GadgetReboot/Rotary_Optical_USB/README.md

# Rotary_Optical_USB
Pi Pico USB Mouse/Keyboard for Arcade Trackball/Spinner and LS30 Mechanical Rotary Joysticks
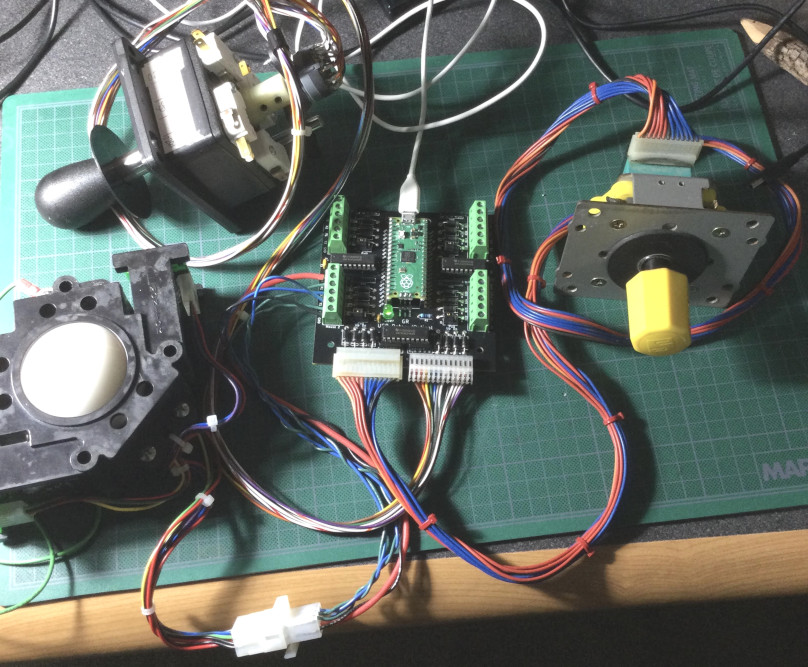
[picture p1: Assembled_PCB.jpg]
PCB
<br><br><br><br>
