GadgetReboot/Rotary_Optical_USB/Alternate_Script_All_Button_Inputs/readme.md

This is a test script that can be used in the pi pico to set all screw terminal inputs as regular button inputs instead of optical encoders to allow fast testing of inputs by grounding each one to generate a keystroke.
