GadgetReboot/Rotary_Optical_USB/RotaryOptical-Schematic.pdf

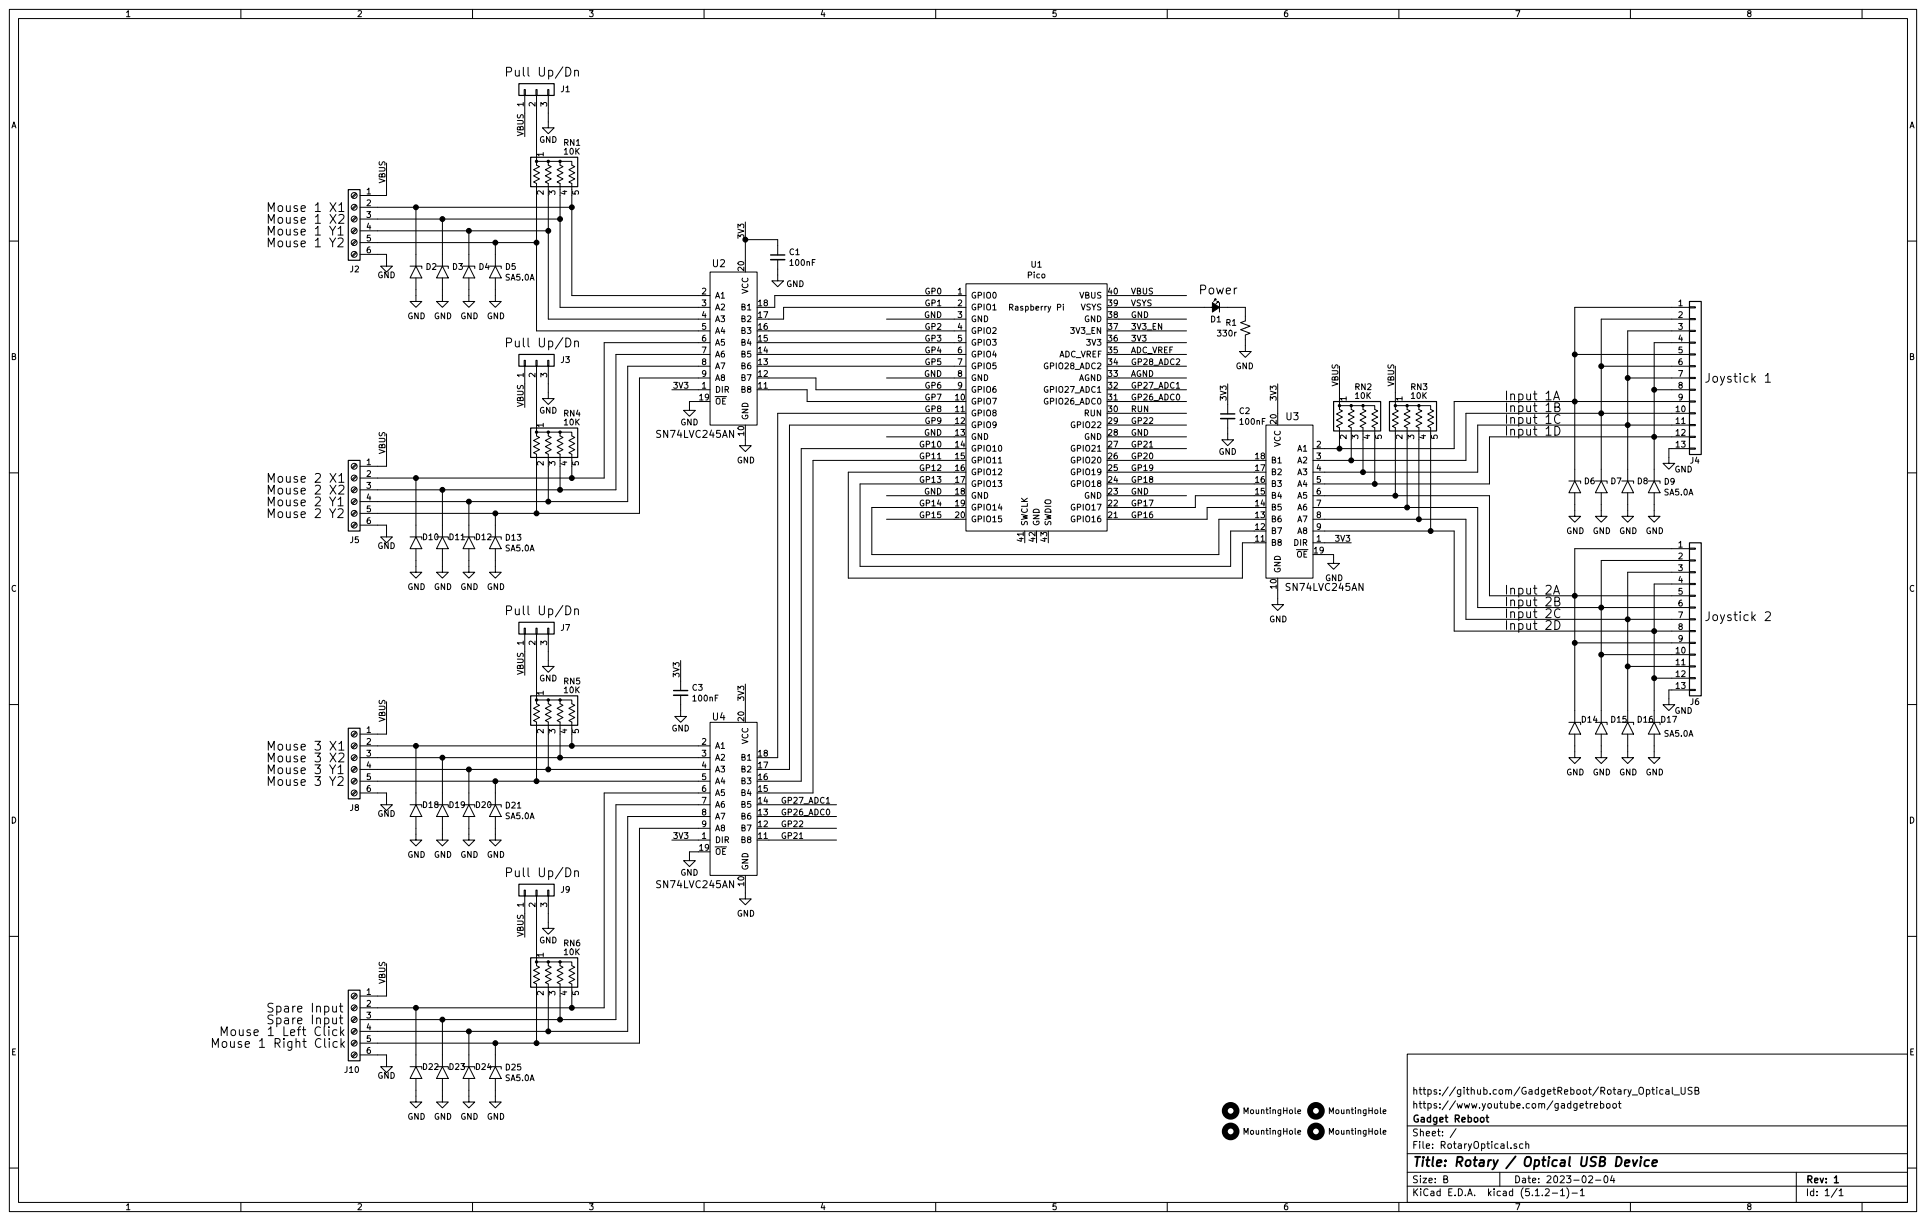
[picture p3: page 1]

Input 1B | 10
Input 1C | 11
Input 1D | 12

Input 2B | 1323456789

Input 2C
Input 2D

10
11
12

https://github.com/GadgetReboot/Rotary_Optical_USB
https://www.youtube.com/gadgetreboot
File: RotaryOptical.sch Sheet: / Gadget Reboot

Id: 1/1 Title: Rotary / Optical USB Device
