GadgetReboot/Rotary_Optical_USB/KiCad/RotaryOptical.kicad_pcb

## KiCad design KiCad/RotaryOptical.kicad_pcb (2023-03-07)

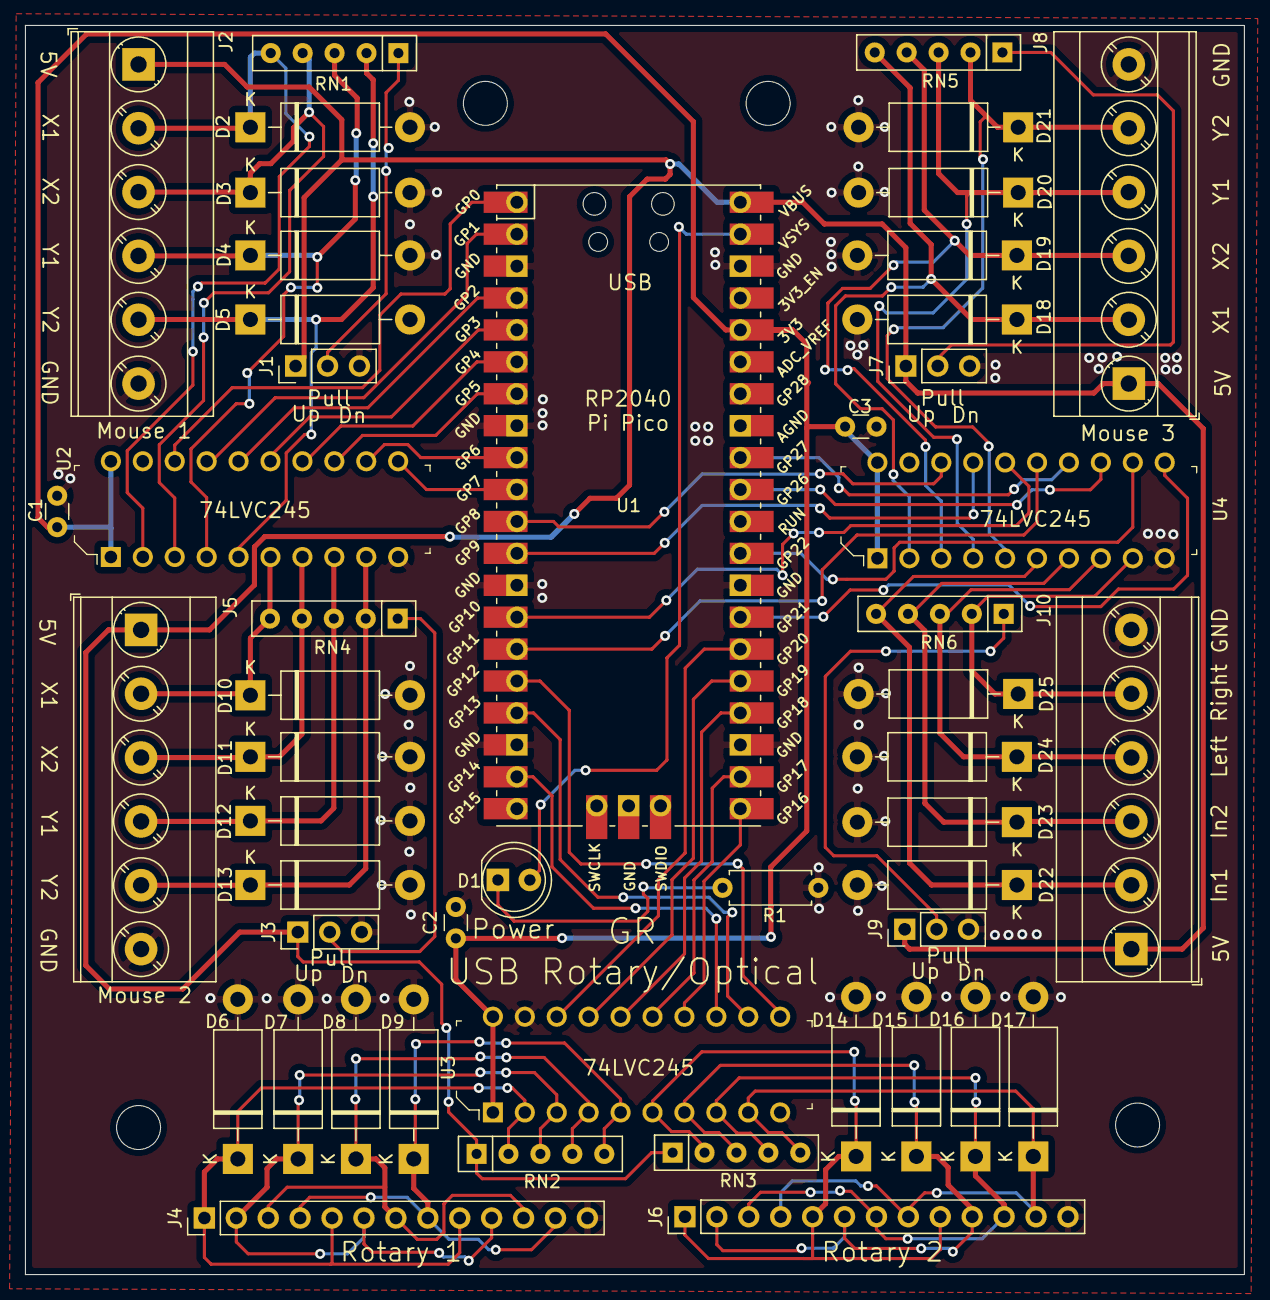
[picture p4: board RotaryOptical.kicad_pcb from above]

Board: 2 copper layers, 97.0 x 99.4 mm, 53 parts (0 on the bottom side), 57 nets.

Parts:
C1, C2, C3: 100nF; C_Disc_D3.0mm_W1.6mm_P2.50mm
D1: LED_Small_ALT; LED_D5.0mm_Clear
D2, D3, D4, D5, D6, D7, D8, D9, D10, D11, D12, D13, D14, D15, D16, D17, D18, D19, D20, D21, D22, D23, D24, D25: SA5.0A; D_DO-15_P12.70mm_Horizontal
H1, H2, H3, H4: MountingHole; MountingHole_3.5mm
J1, J3, J7, J9: Conn_01x03; PinHeader_1x03_P2.54mm_Vertical
J2, J5, J8, J10: Screw_Terminal_01x06; TerminalBlock_Phoenix_MKDS-3-6-5.08_1x06_P5.08mm_Horizontal
J4, J6: Conn_01x13; PinHeader_1x13_P2.54mm_Vertical
R1: 470r; R_Axial_DIN0207_L6.3mm_D2.5mm_P7.62mm_Horizontal
RN1, RN2, RN3, RN4, RN5, RN6: 10K; R_Array_SIP5
U1: Pico; RPi_Pico_SMD_TH
U2, U3, U4: SN74LVC245AN; DIP-20_W7.62mm

Connections:
/3V3: C1.1, C2.1, C3.1, U1.36, U2.1, U2.20, U3.1, U3.20, U4.1, U4.20
/GP0: U1.1, U2.18
/GP1: U1.2, U2.17
/GP2: U1.4, U2.16
/GP3: U1.5, U2.15
/GP4: U1.6, U2.14
/GP5: U1.7, U2.13
/GP6: U1.9, U2.12
/GP7: U1.10, U2.11
/GP8: U1.11, U4.18
/GP9: U1.12, U4.17
/GP10: U1.14, U4.16
/GP11: U1.15, U4.15
/GP12: U1.16, U3.11
/GP13: U1.17, U3.12
/GP14: U1.19, U3.13
/GP16: U1.21, U3.14
/GP17: U1.22, U3.15
/GP18: U1.24, U3.16
/GP19: U1.25, U3.17
/GP20: U1.26, U3.18
/GP21: U1.27, U4.11
/GP22: U1.29, U4.12
/GP26_ADC0: U1.31, U4.13
/GP27_ADC1: U1.32, U4.14
/VBUS: J1.1, J2.1, J3.1, J5.1, J7.1, J8.1, J9.1, J10.1, RN2.1, RN3.1, U1.40
/VSYS: D1.2, U1.39
GND: C1.2, C2.2, C3.2, D2.2, D3.2, D4.2, D5.2, D6.2, D7.2, D8.2, D9.2, D10.2, D11.2, D12.2, D13.2, D14.2, D15.2, D16.2, D17.2, D18.2, D19.2, D20.2, D21.2, D22.2, D23.2, D24.2, D25.2, J1.3, J2.6, J3.3, J4.13, J5.6, J6.13, J7.3, J8.6, J9.3, J10.6, R1.2, U1.3, U1.8, U1.13, U1.18, U1.23, U1.28, U1.38, U2.10, U2.19, U3.10, U3.19, U4.10, U4.19
unnamed: D1.1, R1.1
unnamed: D2.1, J2.2, RN1.5, U2.2
unnamed: D3.1, J2.3, RN1.4, U2.3
unnamed: D4.1, J2.4, RN1.3, U2.4
unnamed: D5.1, J2.5, RN1.2, U2.5
unnamed: D6.1, J4.1, J4.5, J4.9, RN2.2, U3.2
unnamed: D7.1, J4.2, J4.6, J4.10, RN2.3, U3.3
unnamed: D8.1, J4.3, J4.7, J4.11, RN2.4, U3.4
unnamed: D9.1, J4.4, J4.8, J4.12, RN2.5, U3.5
unnamed: D10.1, J5.2, RN4.5, U2.6
unnamed: D11.1, J5.3, RN4.4, U2.7
unnamed: D12.1, J5.4, RN4.3, U2.8
unnamed: D13.1, J5.5, RN4.2, U2.9
unnamed: D14.1, J6.1, J6.5, J6.9, RN3.2, U3.6
unnamed: D15.1, J6.2, J6.6, J6.10, RN3.3, U3.7
unnamed: D16.1, J6.3, J6.7, J6.11, RN3.4, U3.8
unnamed: D17.1, J6.4, J6.8, J6.12, RN3.5, U3.9
unnamed: D18.1, J8.2, RN5.5, U4.2
unnamed: D19.1, J8.3, RN5.4, U4.3
unnamed: D20.1, J8.4, RN5.3, U4.4
unnamed: D21.1, J8.5, RN5.2, U4.5
unnamed: D22.1, J10.2, RN6.5, U4.6
unnamed: D23.1, J10.3, RN6.4, U4.7
unnamed: D24.1, J10.4, RN6.3, U4.8
unnamed: D25.1, J10.5, RN6.2, U4.9
unnamed: J1.2, RN1.1
unnamed: J3.2, RN4.1
unnamed: J7.2, RN5.1
unnamed: J9.2, RN6.1
