GadgetReboot/Rotary_Optical_USB/(threads)

Thread 1 (2023-05-07):

Alternative script?

spotUP, 2023-05-07:
Hi! I have a rotary panel with two ls-30 joysticks and 4 buttons for each player + coin 1 and coin 2.

I have built your encoder, but the script would need some changes to work on my setup, as i need buttons instead of trackballs, and also the directions of the joysticks (up/down/left/right) would need inputs.

I tried to do it myself, but I am not a coder, and it was not as simple as i had thought. =)

Would you consider making an alternative script for this and replace the trackball inputs with buttons instead, it would make the board more universal, and that is a good thing, right?

GadgetReboot, 2023-05-07:
Do you need all of those buttons for both players up down left right + 4 buttons each + coin 1 and 2?   4+4+4+4+2
If so the board doesn't have enough inputs, there's 2 less than needed:  4xMouse1, 4xMouse2, 4xMouse3, and 4x misc mouse buttons and spares
I can still try to make a demo that uses all of those optical and spare inputs as buttons so it can be used if needed and it can be used for board testing without needing all the optical hardware.

spotUP, 2023-05-08:
Coin 1+2 could be skipped. =)

GadgetReboot, 2023-05-08:
Try this alternate script  https://github.com/GadgetReboot/Rotary_Optical_USB/tree/main/Alternate_Script_All_Button_Inputs

All screw terminal inputs are now looking for button presses to ground and will press/release keystrokes as buttons are pressed/released.  The joystick rotations are still detected as usual.

The script can be edited to generate whatever keyboard keys should be assigned to each input

spotUP, 2023-05-09:
Thanks, i tried it, it might work. The broken board with the two unwanted holes in the other issue thread is my board, it was my friend who soldered it, so that's why he posted the issue.

One resistor is broken on my board and those two holes might make things wonky as well, so only two connectors works as intended. One is totally dead and one sends 3 chars for every button press.

Do you have any prebuilt adaptors for sale?

GadgetReboot, 2023-05-09:
I only have the one unit I made for the testing so I don't have any to sell.
If the resistor is replaced and the weird holes are separated by making those cuts to sever copper, I wonder if it would all work normal.

Closed 2023-05-10.

Thread 2 (2023-05-08):

Found stange pin holes

micklen, 2023-05-08:
HI,
I found two through holes and wonder what shall be solder in here?
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

micklen, 2023-05-08:
Second picture is take from below

GadgetReboot, 2023-05-08:
That's weird, and not in the original design or on my physical boards!
Here's what the design file looks like on top and bottom in that area.
Did you order directly from PCBWay shared projects or did you upload gerber files manually?

It looks like someone stuck an extra component on the board and manufactured that instead of the original file.
And it looks like those through holes are shorting those tracks to the ground plane on the bottom side so it may not be able to be ignored.
To get it up and running I'd take a knife and cut along the 3 green marked areas to make sure it's not connected to ground or a nearby pad.
Then I'd look over the board to see if there's any other weird stuff thrown in there, and contact the board shop to ask WTF...and get a refund!  I've never had that happen.

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

Closed 2023-05-10.

Thread 3 (2024-06-18):

spinner support (encoder)

gkozlowski-git, 2024-06-18:
I built the project. Everything is fine. However, I would like to use it additionally to operate two spinners. Would there be a chance you could post an alternative script with support? Unfortunately, I am not a programmer and it is difficult for me to convert the XY axis to XX.

GadgetReboot, 2024-06-18:
I'm also not much of a programmer and I need to try to re-learn anything I took from other places and jammed together.
I see in the script there is a mouse implemented on axis 2  and then 1 and 3 are left not implemented (I forget why).

Is the goal to just have a single mouse device but just being able to permanently wire up alternate axis controllers on the screw terminals and they all control the same cursor depending which one is used,

or is it to have multiple separate mouse cursors that are their own separate devices (I don't know if that can be done, it would take a lot of research to see)?

gkozlowski-git, 2024-06-18:
Only one cursor, but three devices (trackball on Mouse2 and two spinners on Mouse1).
Two spinners can be used at the same time, just like a rotary joystick.

GadgetReboot, 2024-06-18:
I attempted to implement all 3 mouse X-Y inputs with some copy/paste and axis number renaming, but I don't currently have a test setup to verify anything so you can try it and see if it works.
I made  a new folder for the version 1 old code and this new version 2.
https://github.com/GadgetReboot/Rotary_Optical_USB/tree/main/Circuit_Python_Script/ver2
